ut-ras/robomaster_hardware/Turret/Turret 1.xlsx

Sheet: Full
Reference | Value | Mouser Part Number | Qty
+19V_Turret->Orin1, +24V_Feeder1, +24V_Gimbal1, +24V_L_Flywheel1, +24V_R_Flywheel1, +24V_Waterwheel1 | Conn_01x02_Pin | XT30 | 6
+5V1, +19V1, +24V_Gimbal2, +24V_Shooter2, GND1 | TestPoint | Testpoint | 5
Debug_Orin->Turret1, Debug_Turret->Chassis1, Ref_In1, Ref_Out1, UART_Chassis->Turret1, UART_Turret->Orin1 | Conn_01x04_Pin | JST 4 Pin | 6
CAN_Feeder1, CAN_Gimbal1, CAN_In1, CAN_In2, CAN_L_Flywheel1, CAN_R_Flywheel1, CAN_Waterwheel1 | Conn_01x02_Pin | JST 2 Pin | 7
8_Pin_Slipring->Turret1 | Conn_01x08_Pin | 538-172298-1108 | 1
H1-H4 | MountingHole |  | 4

Sheet: Thing we prob dont have
8_Pin_Slipring->Turret1 | Conn_01x08_Pin | 538-172298-1108 | 1
