ut-ras/robomaster_hardware/Turret/Turret.step

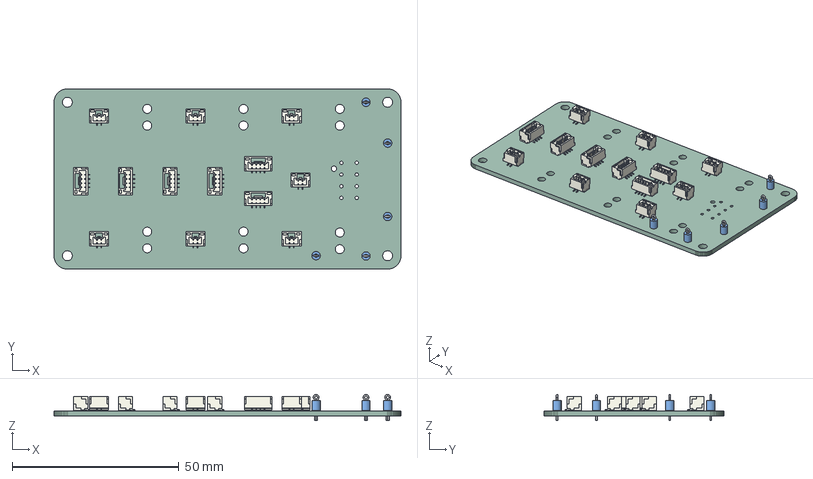
[picture p1: CAD file, 2024-09-17]
Turret/Turret.step
104.0 x 54.0 x 7.87 mm
Turret PCB
