ut-ras/robomaster_hardware/Chassis/Chassis.kicad_pcb

## KiCad design Chassis/Chassis.kicad_pcb (2024-11-16)

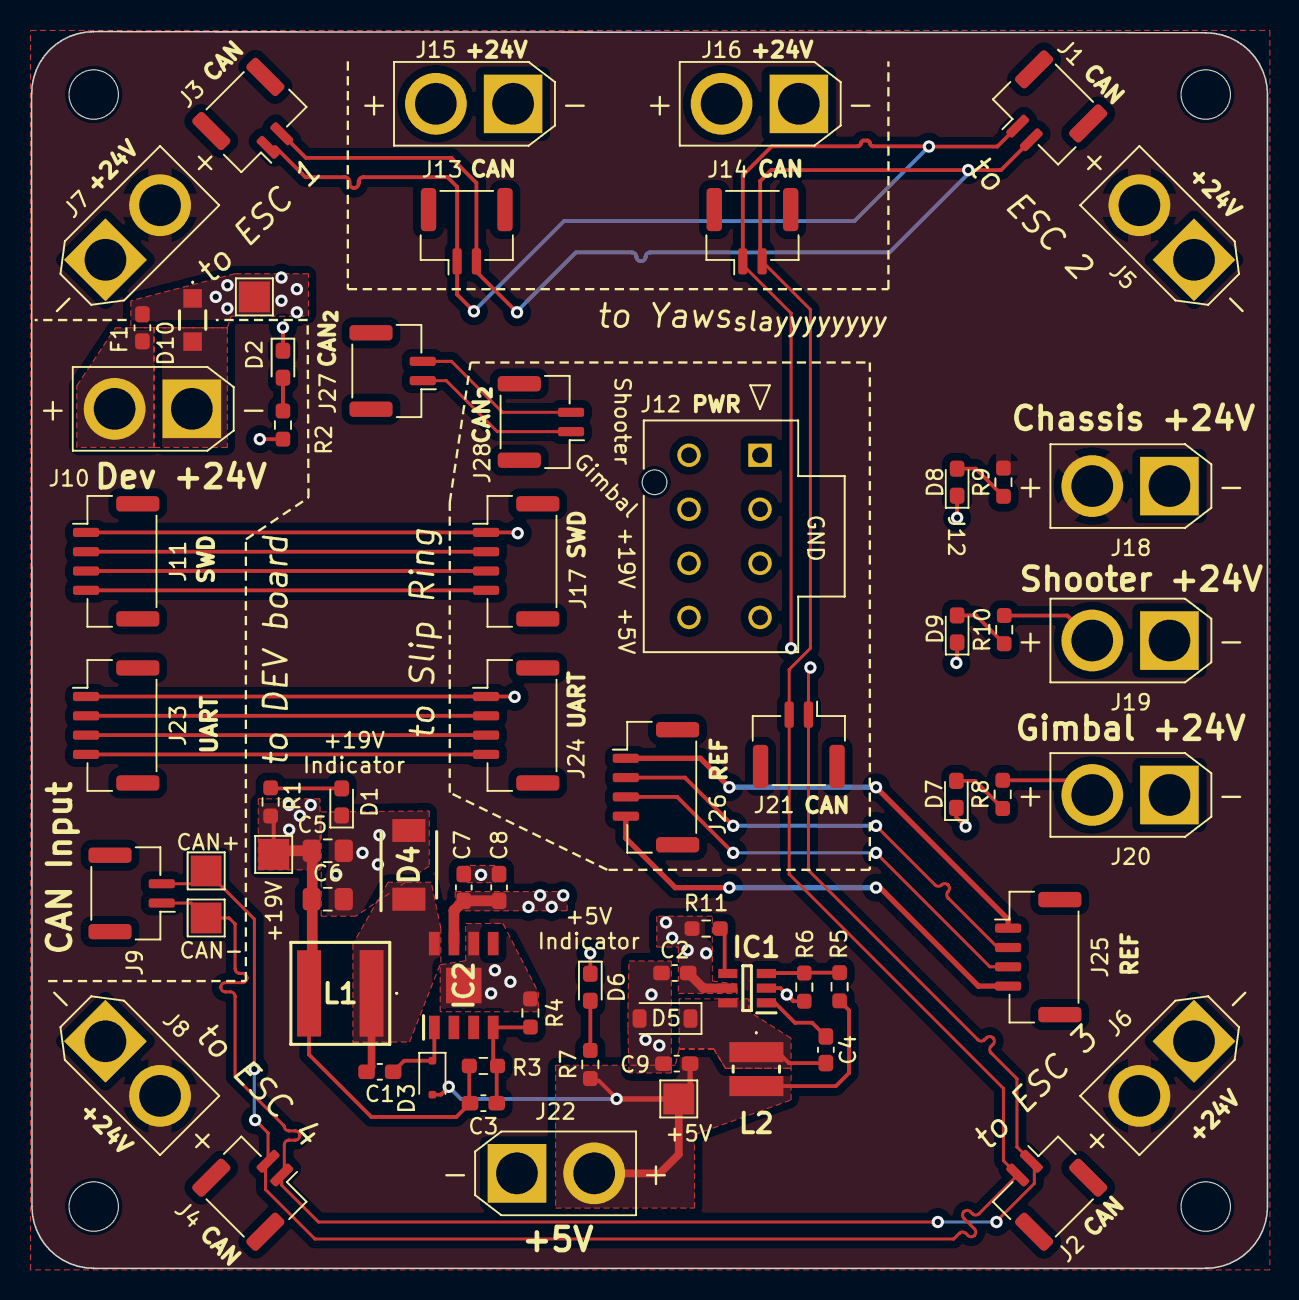
[picture p2: board Chassis.kicad_pcb from above]

Board: 4 copper layers, 80.0 x 80.1 mm, 72 parts (0 on the bottom side), 35 nets.

Parts:
C1, C9: 10nF; C_0603_1608Metric_Pad1.08x0.95mm_HandSolder
C2: 2.2μF; C_0603_1608Metric_Pad1.08x0.95mm_HandSolder
C3: 82pF; C_0603_1608Metric_Pad1.08x0.95mm_HandSolder
C4: 100nF; C_0603_1608Metric_Pad1.08x0.95mm_HandSolder
C5, C6: 22µF; C_0805_2012Metric_Pad1.18x1.45mm_HandSolder
C7, C8: 4.7µF; C_0603_1608Metric_Pad1.08x0.95mm_HandSolder
D1: 150060BS75000; LED_0603_1608Metric_Pad1.05x0.95mm_HandSolder
D2: 150060RS75000; LED_0603_1608Metric_Pad1.05x0.95mm_HandSolder
D3: BAS321J; D_SOD-323F
D4: SR54F-AU_R2_000A1; SODFL5336X110N
D5: SD103AW-TP; D_SOD-123
D6: 150060GS75000; LED_0603_1608Metric_Pad1.05x0.95mm_HandSolder
D7, D8, D9: 150060YS75000; LED_0603_1608Metric_Pad1.05x0.95mm_HandSolder
D10: PTVS26VS1UR-QX; PTVS26VS1URQX
F1: 2.5A; Fuse_0603_1608Metric_Pad1.05x0.95mm_HandSolder
H1, H2, H3, H4: MountingHole; MountingHole_3.2mm_M3
IC1: LV2862YDDCR; SOT95P280X110-6N
IC2: RT6285GSP; SOIC127P600X175-9N
J1: FR_JST; JST_GH_BM02B-GHS-TBT_1x02-1MP_P1.25mm_Vertical
J2: BR_JST; JST_GH_BM02B-GHS-TBT_1x02-1MP_P1.25mm_Vertical
J3: FL_JST; JST_GH_BM02B-GHS-TBT_1x02-1MP_P1.25mm_Vertical
J4: BL_JST; JST_GH_BM02B-GHS-TBT_1x02-1MP_P1.25mm_Vertical
J5: FR_XT30; AMASS_XT30U-F_1x02_P5.0mm_Vertical
J6: BR_XT30; AMASS_XT30U-F_1x02_P5.0mm_Vertical
J7: FL_XT30; AMASS_XT30U-F_1x02_P5.0mm_Vertical
J8: BL_XT30; AMASS_XT30U-F_1x02_P5.0mm_Vertical
J9: IN_JST; JST_GH_BM02B-GHS-TBT_1x02-1MP_P1.25mm_Vertical
J10: IN_XT30; AMASS_XT30U-F_1x02_P5.0mm_Vertical
J11: SWD_IN; JST_GH_BM04B-GHS-TBT_1x04-1MP_P1.25mm_Vertical
J12: Conn_01x08_Pin; CON_1722981108_MOL
J13: GIM1_JST; JST_GH_BM02B-GHS-TBT_1x02-1MP_P1.25mm_Vertical
J14: GIM2_JST; JST_GH_BM02B-GHS-TBT_1x02-1MP_P1.25mm_Vertical
J15: GIM1_XT30; AMASS_XT30U-F_1x02_P5.0mm_Vertical
J16: GIM2_XT30; AMASS_XT30U-F_1x02_P5.0mm_Vertical
J17: SWD_OUT; JST_GH_BM04B-GHS-TBT_1x04-1MP_P1.25mm_Vertical
J18: CHA_XT30; AMASS_XT30U-F_1x02_P5.0mm_Vertical
J19: SHOO_XT30; AMASS_XT30U-F_1x02_P5.0mm_Vertical
J20: GIM_XT30; AMASS_XT30U-F_1x02_P5.0mm_Vertical
J21: OUT_JST; JST_GH_BM02B-GHS-TBT_1x02-1MP_P1.25mm_Vertical
J22: 5V_XT30; AMASS_XT30U-F_1x02_P5.0mm_Vertical
J23: UART_IN; JST_GH_BM04B-GHS-TBT_1x04-1MP_P1.25mm_Vertical
J24: UART_Out; JST_GH_BM04B-GHS-TBT_1x04-1MP_P1.25mm_Vertical
J25: REF_IN; JST_GH_BM04B-GHS-TBT_1x04-1MP_P1.25mm_Vertical
J26: REF_OUT; JST_GH_BM04B-GHS-TBT_1x04-1MP_P1.25mm_Vertical
J27: CAN2_IN; JST_GH_BM02B-GHS-TBT_1x02-1MP_P1.25mm_Vertical
J28: CAN2_OUT; JST_GH_BM02B-GHS-TBT_1x02-1MP_P1.25mm_Vertical
L1: 10µH; MPLAL6060100
L2: 33μH; SRN3012BTA330M
R1, R2, R8, R9, R10: 1kΩ; R_0603_1608Metric_Pad0.98x0.95mm_HandSolder
R3, R11: 100kΩ; R_0603_1608Metric_Pad0.98x0.95mm_HandSolder
R4: 6.8kΩ; R_0603_1608Metric_Pad0.98x0.95mm_HandSolder
R5: 56kΩ; R_0603_1608Metric_Pad0.98x0.95mm_HandSolder
R6: 10kΩ; R_0603_1608Metric_Pad0.98x0.95mm_HandSolder
R7: 250Ω; R_0603_1608Metric_Pad0.98x0.95mm_HandSolder
TP1, TP2, TP3, TP4, TP5: TestPoint; TestPoint_Pad_2.0x2.0mm

Connections:
+3.3V: J11.4, J17.4
+3V3: J23.4, J24.4
+5V: C9.1, D3.2 (A), J12.8, J22.2, L2.2, R5.2, R7.1, TP5.1
+19V: C3.1, C5.1, C6.1, J12.7, L1.2, R1.1, R3.1, TP4.1
+24V: C2.1, C7.1, C8.1, D10.1 (K), F1.2, IC1.5 (VIN), IC2.7 (VIN), R2.2, R11.2, TP3.1
+24V_Chassis: J5.2, J6.2, J7.2, J8.2, J18.2, R9.2
+24V_Gimbal: J12.6, J15.2, J16.2, J20.2, R8.2
+24V_Shooter: J12.5, J19.2, R10.2
/24V -> 19V Buck Convertor/BOOT_{5}: C4.1, IC1.1 (CB)
/24V -> 19V Buck Convertor/BOOT_{19}: C1.1, D3.1 (K), IC2.1 (BOOT)
/24V -> 19V Buck Convertor/FB_{5}: IC1.3 (FB), R5.1, R6.1
/24V -> 19V Buck Convertor/FB_{19}: C3.2, IC2.4 (FB), R3.2, R4.1
/24V -> 19V Buck Convertor/SW_{5}: C4.2, D5.1 (K), IC1.6 (SW), L2.1
/24V -> 19V Buck Convertor/SW_{19}: C1.2, D4.1 (K), IC2.8 (SW), L1.1
/24V -> 19V Buck Convertor/~SHDN: IC1.4 (~SHDN), R11.1
/CAN+: J1.2, J2.2, J3.2, J4.2, J9.2, J13.2, J14.2, J21.2, TP2.1
/CAN-: J1.1, J2.1, J3.1, J4.1, J9.1, J13.1, J14.1, J21.1, TP1.1
/REF_CAN+: J25.3, J26.3
/REF_CAN-: J25.2, J26.2
/REF_PWR: J25.4, J26.4
/SWCLK: J11.2, J17.2
/SWDIO: J11.3, J17.3
/UART_RX: J23.3, J24.3
/UART_TX: J23.2, J24.2
CAN2+: J27.2, J28.2
CAN2-: J27.1, J28.1
GND: C2.2, C5.2, C6.2, C7.2, C8.2, C9.2, D1.1 (K), D2.1 (K), D4.2 (A), D5.2 (A), D6.1 (K), D7.1 (K), D8.1 (K), D9.1 (K), D10.2 (A), IC1.2 (GND), IC2.6 (GND_1), IC2.9 (GND_2), J5.1, J6.1, J7.1, J8.1, J10.1, J11.1, J12.1, J12.2, J12.3, J12.4, J15.1, J16.1, J17.1, J18.1, J19.1, J20.1, J22.1, J23.1, J24.1, R4.2, R6.2
GND1: J25.1, J26.1
Mini_PC: F1.1, J10.2
unnamed: D1.2 (A), R1.2
unnamed: D2.2 (A), R2.1
unnamed: D6.2 (A), R7.2
unnamed: D7.2 (A), R8.1
unnamed: D8.2 (A), R9.1
unnamed: D9.2 (A), R10.1
