ut-ras/robomaster_hardware/Turret/Turret.kicad_pcb

## KiCad design Turret/Turret.kicad_pcb (2024-09-17)

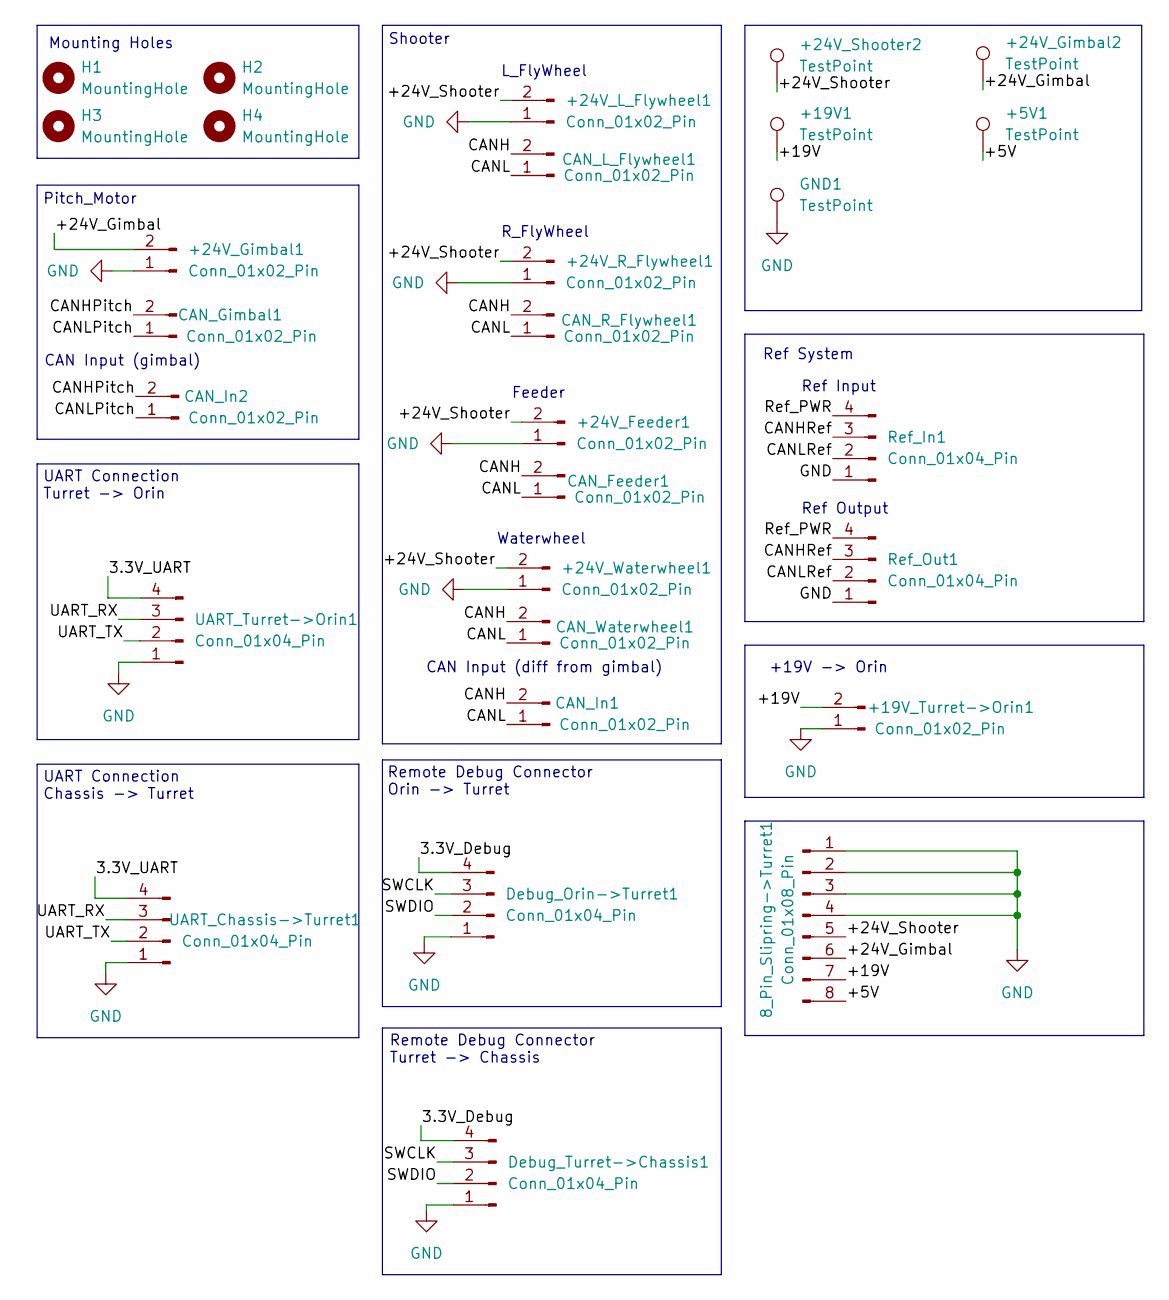
[picture p3: schematic Turret.kicad_sch]

Parts:
8_Pin_Slipring->Turret1: Conn_01x08_Pin; CON_1722981108_MOL; Mouser Part Number 538-172298-1108
+5V1, +19V1, +24V_Gimbal2, +24V_Shooter2: TestPoint; TestPoint_Loop_D1.80mm_Drill1.0mm_Beaded; Mouser Part Number Testpoint
+19V_Turret->Orin1, +24V_Feeder1, +24V_Gimbal1, +24V_L_Flywheel1, +24V_R_Flywheel1, +24V_Waterwheel1: Conn_01x02_Pin; AMASS_XT30U-F_1x02_P5.0mm_Vertical_copy; Mouser Part Number XT30
CAN_Feeder1: Conn_01x02_Pin; JST_GH_BM02B-GHS-TBT_1x02-1MP_P1.25mm_Vertical; Mouser Part Number JST 2 Pin
CAN_Gimbal1: Conn_01x02_Pin; JST_GH_BM02B-GHS-TBT_1x02-1MP_P1.25mm_Vertical; Mouser Part Number JST 2 Pin
CAN_In1, CAN_In2: Conn_01x02_Pin; JST_GH_BM02B-GHS-TBT_1x02-1MP_P1.25mm_Vertical; Mouser Part Number JST 2 Pin
CAN_L_Flywheel1: Conn_01x02_Pin; JST_GH_BM02B-GHS-TBT_1x02-1MP_P1.25mm_Vertical; Mouser Part Number JST 2 Pin
CAN_R_Flywheel1: Conn_01x02_Pin; JST_GH_BM02B-GHS-TBT_1x02-1MP_P1.25mm_Vertical; Mouser Part Number JST 2 Pin
CAN_Waterwheel1: Conn_01x02_Pin; JST_GH_BM02B-GHS-TBT_1x02-1MP_P1.25mm_Vertical; Mouser Part Number JST 2 Pin
Debug_Orin->Turret1: Conn_01x04_Pin; JST_GH_BM04B-GHS-TBT_1x04-1MP_P1.25mm_Vertical; Mouser Part Number JST 4 Pin
Debug_Turret->Chassis1: Conn_01x04_Pin; JST_GH_BM04B-GHS-TBT_1x04-1MP_P1.25mm_Vertical; Mouser Part Number JST 4 Pin
GND1: TestPoint; TestPoint_Loop_D1.80mm_Drill1.0mm_Beaded; Mouser Part Number Testpoint
H1, H2, H3, H4: MountingHole; MountingHole_3mm
Ref_In1: Conn_01x04_Pin; JST_GH_BM04B-GHS-TBT_1x04-1MP_P1.25mm_Vertical; Mouser Part Number JST 4 Pin
Ref_Out1: Conn_01x04_Pin; JST_GH_BM04B-GHS-TBT_1x04-1MP_P1.25mm_Vertical; Mouser Part Number JST 4 Pin
UART_Chassis->Turret1: Conn_01x04_Pin; JST_GH_BM04B-GHS-TBT_1x04-1MP_P1.25mm_Vertical; Mouser Part Number JST 4 Pin
UART_Turret->Orin1: Conn_01x04_Pin; JST_GH_BM04B-GHS-TBT_1x04-1MP_P1.25mm_Vertical; Mouser Part Number JST 4 Pin

Connections:
/3.3V_Debug: Debug_Orin->Turret1.4, Debug_Turret->Chassis1.4
/3.3V_UART: UART_Chassis->Turret1.4, UART_Turret->Orin1.4
/+5V: 8_Pin_Slipring->Turret1.8, +5V1.1
/+19V: 8_Pin_Slipring->Turret1.7, +19V1.1, +19V_Turret->Orin1.2
/+24V_Gimbal: 8_Pin_Slipring->Turret1.6, +24V_Gimbal1.2, +24V_Gimbal2.1
/+24V_Shooter: 8_Pin_Slipring->Turret1.5, +24V_Feeder1.2, +24V_L_Flywheel1.2, +24V_R_Flywheel1.2, +24V_Shooter2.1, +24V_Waterwheel1.2
/CANH: CAN_Feeder1.2, CAN_In1.2, CAN_L_Flywheel1.2, CAN_R_Flywheel1.2, CAN_Waterwheel1.2
/CANHPitch: CAN_Gimbal1.2, CAN_In2.2
/CANHRef: Ref_In1.3, Ref_Out1.3
/CANL: CAN_Feeder1.1, CAN_In1.1, CAN_L_Flywheel1.1, CAN_R_Flywheel1.1, CAN_Waterwheel1.1
/CANLPitch: CAN_Gimbal1.1, CAN_In2.1
/CANLRef: Ref_In1.2, Ref_Out1.2
/Ref_PWR: Ref_In1.4, Ref_Out1.4
/SWCLK: Debug_Orin->Turret1.3, Debug_Turret->Chassis1.3
/SWDIO: Debug_Orin->Turret1.2, Debug_Turret->Chassis1.2
/UART_RX: UART_Chassis->Turret1.3, UART_Turret->Orin1.3
/UART_TX: UART_Chassis->Turret1.2, UART_Turret->Orin1.2
GND: 8_Pin_Slipring->Turret1.1, 8_Pin_Slipring->Turret1.2, 8_Pin_Slipring->Turret1.3, 8_Pin_Slipring->Turret1.4, +19V_Turret->Orin1.1, +24V_Feeder1.1, +24V_Gimbal1.1, +24V_L_Flywheel1.1, +24V_R_Flywheel1.1, +24V_Waterwheel1.1, Debug_Orin->Turret1.1, Debug_Turret->Chassis1.1, GND1.1, Ref_In1.1, Ref_Out1.1, UART_Chassis->Turret1.1, UART_Turret->Orin1.1

Notes on the sheet:
Ref Input
Ref System
L_FlyWheel
Feeder
Pitch_Motor
Mounting Holes
UART Connection Chassis -> Turret
+19V -> Orin
Remote Debug Connector Orin -> Turret
Remote Debug Connector Turret -> Chassis
Ref Output
CAN Input (gimbal)
Shooter
Waterwheel
CAN Input (diff from gimbal)
R_FlyWheel
UART Connection Turret -> Orin

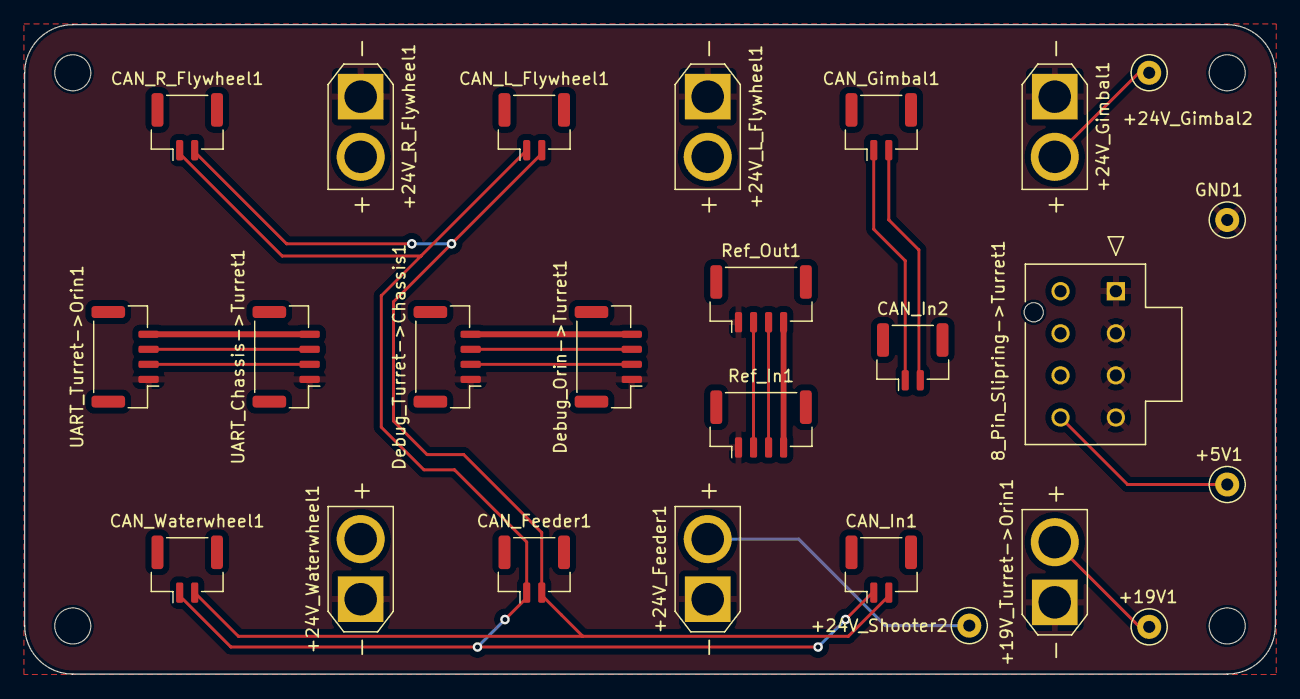
[picture p4: board Turret.kicad_pcb from above]

Board: 2 copper layers, 104.0 x 54.0 mm, 29 parts (0 on the bottom side), 18 nets.
