ut-ras/robomaster_hardware/Devboard_Shield/Dev_Board.kicad_pcb

## KiCad design Devboard_Shield/Dev_Board.kicad_pcb (2024-09-17)

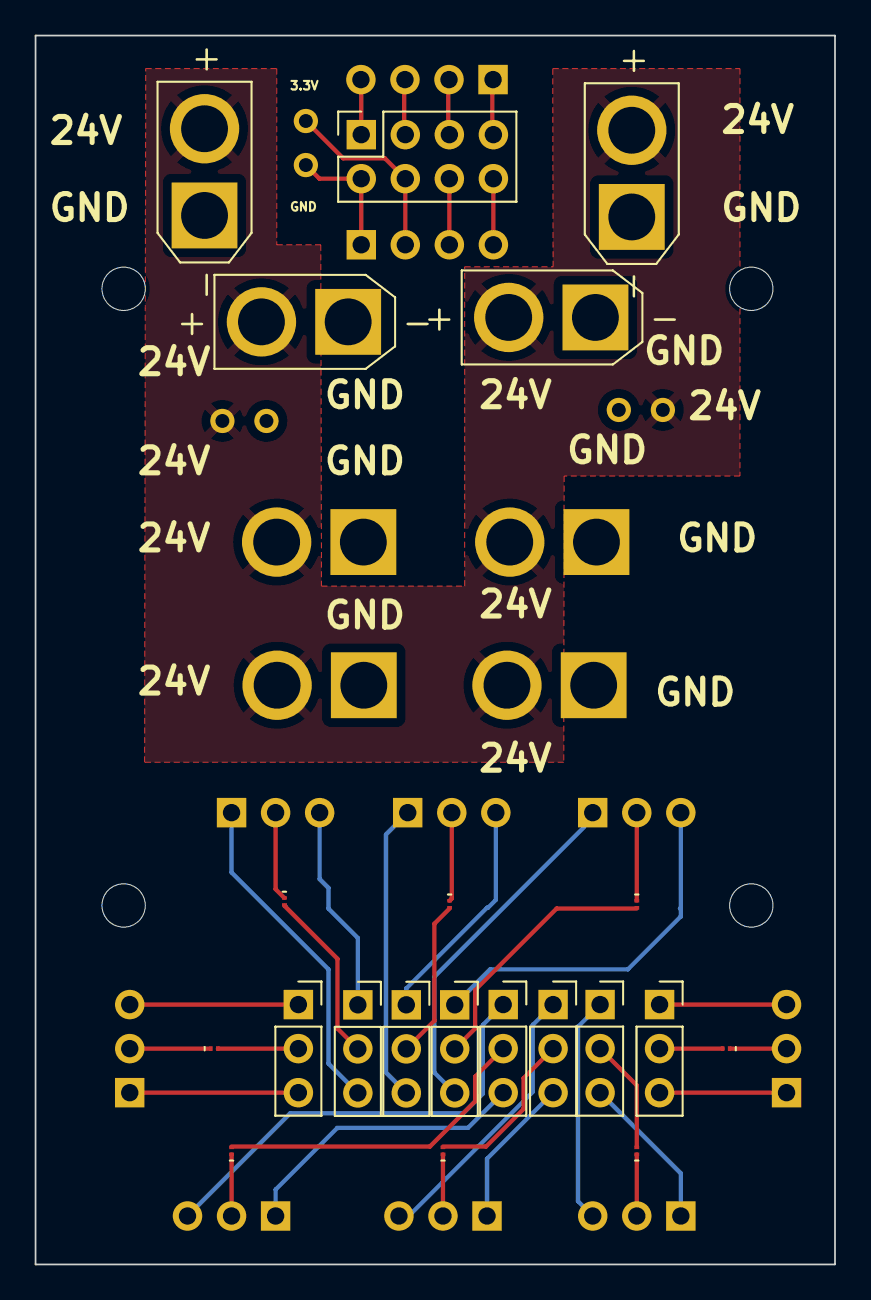
[picture p5: board Dev_Board.kicad_pcb from above]

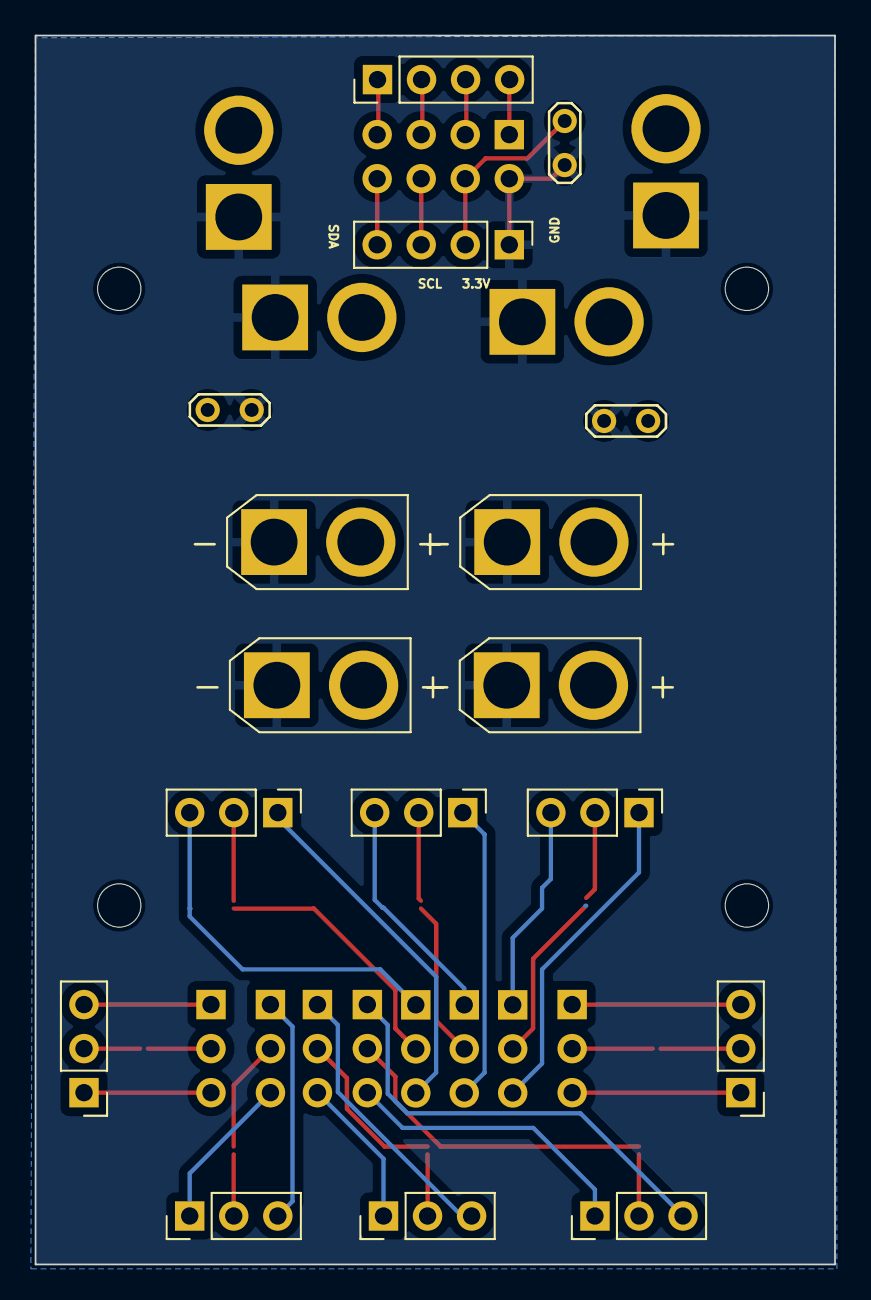
[picture p6: board Dev_Board.kicad_pcb from below]

Board: 2 copper layers, 46.1 x 70.9 mm, 42 parts (17 on the bottom side), 40 nets.

Parts:
D1, D4, D7, D11, D14, D17, D20, D23: D; Nexperia_DSN0603-2_0.6x0.3mm_P0.4mm
DBUS1: Conn_01x03; PinSocket_1x03_P2.54mm_Vertical
H1, H2, H3, H4: MountingHole; MountingHole_2.5mm
IO_Port1: Conn_02x04_Odd_Even; PinSocket_2x04_P2.54mm_Vertical
In_Port1, In_Port2: Conn_01x02; AMASS_XT30U-F_1x02_P5.0mm_Vertical
J1, J2: Conn_01x04; PinHeader_1x04_P2.54mm_Vertical
Out_Port1, Out_Port2, Out_Port3, Out_Port4, Out_Port6, Out_Port8: Conn_01x02; AMASS_XT30U-F_1x02_P5.0mm_Vertical
PWM_R1, PWM_R2, PWM_R3, PWM_R4, PWM_R5, PWM_R6, PWM_R7: Conn_01x03; PinSocket_1x03_P2.54mm_Vertical
PWM_R8, PWM_R9, PWM_R10, PWM_R11, PWM_R12, PWM_R13, PWM_R14, PWM_R15: Conn_01x03; PinHeader_1x03_P2.54mm_Vertical
TP1, TP4, TP5: TestPoint_2Pole; TestPoint_2Pads_Pitch2.54mm_Drill0.8mm

Connections:
+3.3V: IO_Port1.4, J2.2, TP1.2
+24V: In_Port1.2, In_Port2.2, Out_Port1.2, Out_Port2.2, Out_Port3.2, Out_Port4.2, Out_Port6.2, Out_Port8.2, TP4.2, TP5.2
/A2: PWM_R2.1, PWM_R9.3
/A3: PWM_R3.1, PWM_R10.3
/A4: PWM_R4.1, PWM_R11.3
/A5: PWM_R5.1, PWM_R12.3
/A6: PWM_R6.1, PWM_R13.3
/B1 (5V): D1.2 (A), PWM_R1.2
/B3: D7.2 (A), PWM_R3.2
/B4: D11.2 (A), PWM_R4.2
/B5: D14.2 (A), PWM_R5.2
/B6: D17.2 (A), PWM_R6.2
/C3: PWM_R3.3, PWM_R10.1
/C4: PWM_R4.3, PWM_R11.1
/C5: PWM_R5.3, PWM_R12.1
/C8: DBUS1.3, PWM_R15.1
/I2C2_SCL: IO_Port1.6, J2.3
/I2C2_SDA: IO_Port1.8, J2.4
/SPI2_CLK: IO_Port1.3, J1.3
/SPI2_CS: IO_Port1.1, J1.4
/SPI2_MOSI: IO_Port1.5, J1.2
GND: IO_Port1.2, In_Port1.1, In_Port2.1, J2.1, Out_Port1.1, Out_Port2.1, Out_Port3.1, Out_Port4.1, Out_Port6.1, Out_Port8.1, TP1.1, TP4.1, TP5.1
unnamed: D1.1 (K), PWM_R8.2
unnamed: D4.2 (A), PWM_R2.2
unnamed: D4.1 (K), PWM_R9.2
unnamed: D7.1 (K), PWM_R10.2
unnamed: D11.1 (K), PWM_R11.2
unnamed: D14.1 (K), PWM_R12.2
unnamed: D17.1 (K), PWM_R13.2
unnamed: D20.2 (A), PWM_R7.2
unnamed: D20.1 (K), PWM_R14.2
unnamed: D23.2 (A), DBUS1.2
unnamed: D23.1 (K), PWM_R15.2
unnamed: DBUS1.1, PWM_R15.3
unnamed: PWM_R1.1, PWM_R8.3
unnamed: PWM_R1.3, PWM_R8.1
unnamed: PWM_R2.3, PWM_R9.1
unnamed: PWM_R6.3, PWM_R13.1
unnamed: PWM_R7.3, PWM_R14.1
unnamed: PWM_R7.1, PWM_R14.3
