ut-ras/robomaster_hardware/(threads)

Thread 13 (2024-03-27):

Turret Board silkscreen

Lakshay983, 2024-03-27:
The turret board should have some silkscreen on there that indicates which pin corresponds to what. Makes it easier to determine pinouts and where connectors should go.
Mostly around the molex connector
