ut-ras/robomaster_hardware/(commit log)

2023-09-09 initial chassis setup
    [Chassis.kicad_pcb, Chassis.kicad_sch]
2023-09-15 Create a .gitignore for the Chassis project
    [Chassis.kicad_sch]
2023-09-17 Added submodule for Kicad and set libraries
    [Chassis.kicad_sch]
2023-09-22 Added all connectors + assigned footprints + created PCB file
    Starting layout now
    [Chassis.kicad_pcb, Chassis.kicad_sch]
2023-09-23 Change polarity of pins + add circular trace
    [Chassis.kicad_pcb, Chassis.kicad_sch]
2023-09-24 Routed CAN lines + made hole octagonal
    + differential pair skew fixed
    Dimensions may be subject to change, will have to redimension and reroute
    [Chassis.kicad_pcb]
2023-09-24 Fixed colinear traces
    [Chassis.kicad_pcb]
2023-09-24 Possible indicator method?
    [Chassis.kicad_sch]
2023-09-29 Lakshay's method
    I disagree
    [Chassis.kicad_sch]
2023-09-29 Change to MOSFET architecture
    Low-side switching ftw
    [Chassis.kicad_sch]
2023-10-14 Added Resistor and LED footprints to schematic
    [Chassis.kicad_sch]
2023-10-20 Edit test point placement
    [Chassis.kicad_sch]
2023-10-22 Completed initial layout
    I'm going to get roasted over some of these choices
    [Chassis.kicad_pcb, Chassis.kicad_sch, buck.kicad_sch]
2023-10-22 Finalized board design
    I think
    Also added more 3D models and whatnot
    [Chassis.kicad_pcb, Chassis.kicad_sch, buck.kicad_sch]
2023-10-22 Rearrange parts
    [Chassis.kicad_pcb]
2023-10-22 Add big boy connector
    [Chassis.kicad_sch, buck.kicad_sch]
2023-10-22 move around connector
    g'night
    [Chassis.kicad_pcb]
2023-10-27 Add power connector
    big boy
    [Chassis.kicad_pcb]
2023-11-03 Add vias to reduce current loops
    [Chassis.kicad_pcb]
2023-11-03 Added mounting holes
    [Buck.kicad_pcb, Buck.kicad_sch, Chassis.kicad_pcb, Chassis.kicad_sch, buck.kicad_sch]
2023-11-04 Added pour for output
    Will need to add +5V buck + data connector + new power connector
    AAAAAAAAAAAAAAAAAAAAAAA
    [Chassis.kicad_pcb, Chassis.kicad_sch, buck.kicad_sch]
2023-11-10 updated xt30 footprints
    [Chassis.kicad_pcb, Chassis.kicad_sch]
2023-11-11 Add box to schematic
    [Chassis.kicad_sch]
2023-11-17 +5V buck
    [Chassis.kicad_pcb, Chassis.kicad_sch, buck.kicad_sch]
2023-11-18 Pass DRC
    [Chassis.kicad_pcb, buck.kicad_sch]
2023-11-18 Adjust silkscreen
    [Chassis.kicad_pcb]
2023-11-18 Bury 5V feedback line b/c it ugly
    [Chassis.kicad_pcb]
2023-11-18 Straightened some kinks
    [Chassis.kicad_pcb, Chassis.kicad_sch]
2023-11-18 Remove some silks
    [Chassis.kicad_pcb]
2023-11-18 Add random microfit connector
    For data outputs
    [Chassis.kicad_pcb, Chassis.kicad_sch]
2023-12-02 began adding traces :p
    [Chassis.kicad_pcb]
2023-12-19 Added test points + part number for diode
    [Chassis.kicad_pcb, Chassis.kicad_sch, buck.kicad_sch]
2023-12-20 attempted to wire buck converter
    [Chassis.kicad_pcb]
2024-01-04 Remove unnecessary holes + made some thermal vias into direct pours
    [Chassis.kicad_pcb, Chassis.kicad_sch]
2024-01-05 Clear PCB
    Rerouting hajimaruyo
    [Chassis.kicad_pcb]
2024-01-05 Started routing some things
    Got connectors in mostly where they should be + general 5V buck layout done
    [Chassis.kicad_pcb]
2024-01-06 Much more pleasant dimensions
    [Chassis.kicad_pcb]
2024-01-07 Lots of placements
    Big blocks done, time to shuffle them around until I'm happy + route them
    4-layer board in the future?
    [Chassis.kicad_pcb, Chassis.kicad_sch, buck.kicad_sch]
2024-01-16 Did minor routing
    [Chassis.kicad_pcb]
2024-01-20 added mnfr numbers
    [Chassis.kicad_sch, buck.kicad_sch]
2024-01-20 Finished routing
    Turns out we don't need the +5V buck kek
    [Chassis.kicad_pcb, buck.kicad_sch]
2024-01-27 added gimble power & motor connectors
    [Chassis.kicad_pcb, Chassis.kicad_sch]
2024-01-27 some things
    [Chassis.kicad_pcb, Chassis.kicad_sch]
2024-02-02 update KiCad_Library
2024-02-02 Resizing again :D
    [Chassis.kicad_pcb]
2024-02-03 made 80x80 & changed to 8 pin connector
    [Chassis.kicad_pcb, Chassis.kicad_sch, Chassis.step]
2024-02-17 added power sources
    [Chassis.kicad_sch]
2024-02-24 Moved stuff around
    yeah
    [Chassis.kicad_pcb, Chassis.kicad_sch]
2024-03-02 layout done need to do ref system
    [Chassis.kicad_pcb, Chassis.kicad_sch]
2024-03-06 added traces, need to update pcb from schematic
    [Chassis.kicad_pcb, Chassis.kicad_sch]
2024-03-06 finishing touches!
    [Chassis.kicad_pcb, Chassis.kicad_sch]
2024-03-06 Touched up everything
    Improved pours + thermal pads, better routing, trace length matching
    [Chassis.kicad_pcb, Chassis.kicad_sch, buck.kicad_sch]
2024-03-07 Cleaned up silkscreen
    Went ham ngl
    Also passes all DRC checks
    [Chassis.kicad_pcb, Chassis.kicad_sch]
2024-03-08 J12 silkscreen names
    [Chassis.kicad_pcb]
2024-03-09 Create new STEP files
    [Chassis.kicad_pcb, Chassis.kicad_sch, buck.kicad_sch]
2024-03-09 Update silkscreen + address Lakshay's concerns
    [Chassis.kicad_pcb, Chassis.kicad_sch]
2024-03-09 Revert "added mnfr numbers"
    This reverts commit 2d12098a45f9cf7c05c795f919f578313cd2247b.
    [Chassis.kicad_sch, buck.kicad_sch]
2024-03-09 Add another pour
    [Chassis.kicad_pcb]
2024-03-18 Add watchdog subsheet
    [Chassis.kicad_sch, watchdog.kicad_sch]
2024-03-18 Update libraries & changed footprints
    [Chassis.kicad_sch, buck.kicad_sch, watchdog.kicad_sch]
2024-03-22 added can2
    [Chassis.kicad_pcb, Chassis.kicad_sch]
2024-03-22 Adjust thingamajigs
    2nd CAN, silkscreen
    [Chassis.kicad_pcb, Chassis.kicad_sch]
2024-03-22 Remove unnecessary silkscreen + generate IBOM
    [Chassis.kicad_pcb]
2024-03-22 Adj silk
    [Chassis.kicad_pcb]
2024-03-22 Add le pikja
    [Chassis.kicad_pcb]
2024-03-22 Add names to board
    [Chassis.kicad_pcb]
2024-03-22 BOMs away
    [Chassis.kicad_sch, buck.kicad_sch]
2024-03-23 Add the Roblox face
    [Chassis.kicad_pcb]
2024-03-23 Change output filtering for the +19V to 0805 (Mouser doesn't have 0603)
    [Chassis.kicad_pcb, Chassis.kicad_sch, buck.kicad_sch]
2024-03-23 Update footprints + pass DRC
    [Chassis.kicad_pcb, buck.kicad_sch]
2024-03-23 Fix power protection + adj silk
    [Chassis.kicad_pcb, Chassis.kicad_sch]
2024-03-23 Replace inductor with larger
    Idk how much current it'll need + invalid inductor data for spreadsheet
    [Chassis.kicad_pcb, buck.kicad_sch]
2024-03-24 Update and generate IBOM
    [Chassis.kicad_pcb, Chassis.kicad_sch, buck.kicad_sch]
2024-03-24 Add Gerber files & .ZIP
    [Chassis-B_Cu.gbl, Chassis-B_Mask.gbs, Chassis-B_Paste.gbp, Chassis-B_Silkscreen.gbo, Chassis-Edge_Cuts.gm1, Chassis-F_Cu.gtl, Chassis-F_Mask.gts, Chassis-F_Paste.gtp]
2024-03-29 added bom
2024-03-29 Add BOM (part 2)
    [chassis_bom.csv]
2024-04-02 Update README.md
    with Mouser BOM
2024-04-20 Update submodule + started assembly
2024-04-27 Assembled all passives
2024-09-17 Reorganized chassis, turret, devboard shield, into monorepo
    [Chassis-B_Cu.gbl, Chassis-B_Mask.gbs, Chassis-B_Paste.gbp, Chassis-B_Silkscreen.gbo, Chassis-Edge_Cuts.gm1, Chassis-F_Cu.gtl, Chassis-F_Mask.gts, Chassis-F_Paste.gtp]
2024-09-17 Removed KiCad Lib submodule, will switch to in-repo library
2024-09-17 Renamed directories to match
    [Dev_Board.kicad_pcb, Dev_Board.kicad_sch]
2024-09-17 Actually change Turret dir name?
    [Turret 1.xlsx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]
2024-09-17 Renamed to Turret directory
    [Turret 1.xlsx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]
2024-10-04 Added in KiCad_Library Submodule and Electrical Diagram dir
    [ElectricalDiagram.kicad_pcb, ElectricalDiagram.kicad_sch]
2024-10-11 added first set of stuff for electrical diagram
    [ElectricalDiagram.kicad_sch]
2024-10-11 Updated submodule Kicad_Libarary to most recent vers
2024-10-15 Added PMM and chassis motors/ESCs
    [Chassis.kicad_sch, ElectricalDiagram.kicad_pcb, ElectricalDiagram.kicad_sch, Slipring.kicad_sch, Turret.kicad_sch]
2024-10-18 Prepped Electrical Diagram for meeting
    [Chassis.kicad_sch, ElectricalDiagram.kicad_sch, Slipring.kicad_sch, Turret.kicad_sch]
2024-11-11 Andrew added hierarchical labels to in/out pins on schematic
    [Chassis.kicad_pcb, Chassis.kicad_sch]
2024-11-16 Restored to before merge
    [Chassis.kicad_pcb, Chassis.kicad_sch]
2024-12-07 Added hierarchial labels to chassis board, please look over
    [Chassis.kicad_sch, ElectricalDiagram.kicad_sch]
2024-12-07 Tied together common destination power/ground tags as per request from Jed
    [Chassis.kicad_sch, Turret.kicad_sch]
2025-02-21 Updated electrical diagram and Kicad library
    [Turret.kicad_sch]
2025-02-21 Updated diagram w/ new turret schematic
    [ElectricalDiagram.kicad_sch, Turret.kicad_sch]
2025-02-21 Staged hierarchical changes for chassis, not finished
    [Chassis.kicad_sch, ElectricalDiagram.kicad_sch, buck.kicad_sch]
2025-03-07 staging before meeting
    [Chassis.kicad_sch, ElectricalDiagram.kicad_sch, buck.kicad_sch]
